comradeFreeman/loramobgate/(list of files, drawings)

Other design files:
device/pcb/ant433_.lay6
device/pcb/ant_433_8db.lay6
device/pcb/loramobgate2_3.lay6
