comradeFreeman/loramobgate/(commit log)

2023-01-10 first successfull attempt of communication between device and android
2023-01-11 folders reorganisation. successfull import of device libs to app
2023-01-22 First successful communication. Fixes. UI mod
    [loramobgate.py, loramobgate_168p_lorarf.cpp, main.py, models.py, settings.py]
2023-01-23 Reply.msg FIX, Forward.msg impl, Delete.msg partial logic
    [main.py, models.py, settings.py]
2023-02-07 smart chats load, reception of fragmented messages fix, confirmation fix, os-specific additional spacing in MessageCard, Hash field in MessagePacket, last_transactions test success
    [loramobgate.py, main.py, models.py, settings.py]
2023-02-09 server API initial draft. paths rework. UI: change chat title, search chat. dirs reorganisation
    [loramobgate.py, main.py, models.py, settings.py]
2023-02-23 Minor messenger UI changes. Fixed messenger App abnormal shutdown on Desktop. Fonts problem not solved yet. Moving API to VPS, accordingly changed API_URL.
    [loramobgate.py, main.py, settings.py]
2023-02-25 Fix `unread` logic in messenger UI. Minor UI changes. Code cleanup
    [loramobgate.py, main.py, models.py, settings.py]
2023-03-17 loramobgate: Sqlite DB for pubkeys storing, rename Routing to Network. device: LED usb commands, power converter control over USB removed, changed vendor name to 'lain-is.online'. messenger: added ch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
    [loramobgate.py, loramobgate_168p_lorarf.cpp, main.py, models.py, settings.h, settings.py]
2023-04-03 Messenger: load animation, app icon, logging, placeholder, minor bug fixes, account change based on dev_addr using separate DB files Software: logging, storing pubkeys in DB, keys load during start D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
    [loramobgate.py, loramobgate_168p_lorarf.cpp, main.py, models.py, settings.h, settings.py]
2023-04-09 MIT License (except V-USB/MiniCore related code and V-USB/Minicore) dirs. Docs (ru) finish. Messenger: Bugs fixes
    [eeprom_vars.h, loramobgate.py, loramobgate_168p_lorarf.cpp, main.py]
2023-04-15 Messenger: PyInstaller+Windows spec, PyInstaller+Linux spec, bugfixes, USB+libusb-win32.dll on Windows (success), move android buildozer.spec to its dir Sogtware: test1.py programm to test broadcast 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
    [declarations.py, loramobgate.py, main.py, settings.py, test1.py]
2023-04-15 USB bug fix buildozer spec fix
    [loramobgate.py]
